therealjohnwall1/ANC_chip/peripherals/readme.md

## list of peripherals
- adc: MCP3008(microchip)
