therealjohnwall1/ANC_chip/chip/doc/theory_of_op.md

# Theory of Operation
Anchor interacts with an external microcontroller for bring up and initialization which includes tunining and defining s_taps
along with filling the MAC to allow for rolling multplications on the first iteration. the ANC logic will take in X[n] (external noise)
from a reference microphone(ADC + analog frontend) which will be abstracted/simulated in this implementation.
Then ANC block will then try to predict tap coefficents W(z) using gradient descent while using hard coded S(z) to also adjust/zero out
the noise.

The full chain of operations is shown below, basically the entire system this logic aims to represent.
Compute Chain
If this is unfamilar, a demo/simulation in [`scripts/ans.py`](../../scripts/ans.py) shows the full algorithm at work.

## system of equations/variables

signals

| var | meaning |
|---|---|
| x(n) | reference signal, the ambient noise picked up by the reference mic, before cancellation |
| y(n) | adaptive filter output, the anti-noise signal generated by W(z), sent to the mixer |
| d(n) | primary noise, the ambient noise as it actually arrives at the error mic (after room/ear acoustics) |
| y_s(n) | anti-noise after the real secondary path, y(n) as it arrives at the error mic |
| e(n) | error signal, residual noise at the error mic, e(n) = d(n) - y_s(n), used only to adapt the weights |
| x_f(n) | filtered reference, x(n) passed through the secondary path estimate S_hat(z), used in the weight update |

system blocks / filters

| var | meaning |
|---|---|
| W(z) | adaptive filter, holds the tap weights that shape x(n) into y(n) |
| w(n) | vector of adaptive filter tap weights at time n (the state W(z) updates each sample) |
| w(n+1) | updated tap weights after the LMS update rule is applied |
| S(z) | actual secondary path, everything physical between the dsp output and the error mic (dac, amp, speaker, air, mic, adc) |
| S_hat(z) | secondary path estimate, a modeled copy of S(z), used to pre-filter the reference so the adaptation direction is correct |

parameters

| var | meaning |
|---|---|
| mu | step size / learning rate, controls how fast the weights adapt, too high causes instability, too low causes slow convergence |

## Design Goals/questions
- these objectives/goals were created in order to spec out/design the chip without going in a loop, below are the questions and answers(Shoutout claude for the questions)

- Q: what is tile budget, and what types
- A: 700 pound per analog/digital tile, analog pin cost 600 pound bro please :(
    Fits around 1000 digital logic gates, flops take more area up then combinationals
    Based on this requirement I will need to limit my sampling rate and how short my impulse response time is, the shorter it is(faster convergence but it linearly relates
    to the number of taps(N) i will use)
    From this requirement first revision will try to use Q1.15 point(16 bit wide) registers to save space

- Q:What is the target attenuation, what frequency bands?
- A: 0-1 khz, around 15-25 db attn. 1-2 khz, 5-10db attn.
    Signal band is 0-2khz, meaning min rate is 4khz. However the fold point on a 4khz is 2khz, basically this means theres no room for a anti-aliasing filter,
    a analog filter needs a transition band to let the signals through, not a absolute number. Basically a filter that could filter right up to 2khz and blocks everything
    is impossible.
    Energy above 2khz will alias onto 0-2khz band. Switching to 16khz(nyquist 8) gives 2-8khz as a transition band for the anti-aliasing to work.

- Q:What is the physical form factor, which gives you reference-to-error mic spacing, which gives you a latency budget in microseconds.
- A: airpods require ~100khz range(lowk should do ngl).

## External Behavior
- The system will sample/take in a digital signal at 16khz, the internal clock runs at 66 Mhz giving the chip 4125 cycles to compute for each sample.
Knowing this, an optimal fold ratio will use the most of these cycles will minimizing the total # of multpliers.
For an estimate solving this inequality for our M folds.

$$
\lceil \frac{3N * \text{cycles per MAC}}{M} \rceil = 4125
$$

- locking in 16khz, W(z) span, S(z) span, and the word width will need to be chosen next.
- W(z) span: how long an impulse response the adaptive FIR can represent
- S(z) span: when sending an impulse to the DAC, speaker(anti-noise) will fire and the sound will propgate to the mic. It will get altered doing so, this is how long from the first
arrival till the response is usable.

- Note: Span is N = time * f_s, the longer span the more taps will be needed in the array
Knowing this we want our W(z) to be larger then S(z), also S(z) will be directly related too $\theta_s$, how long the acoustic path rings for after noise is sent through it.
Since idk the hw enclosure setup for this, I will choose TODO: fill this out ngl idk what to put

- T_s: secondary path ring duration, physical property of enclosure(will get this number from physical setup)
how long the acoustic impulse response of the secondary path S(z) (speaker → error mic) takes to ring down
- T_w: control filter memory horizon, design choice, the length of memory that W(z) spans
T_w = K * t_s

K should be tuned(its prob gonna be 2 cuz of budget)
t_w is the memory horizon time, how far back in the past can it recall samples, this is why t_w > t_s, an echo that arrives t_s after an impulse was caused by a reference t_s ago, to cancel it the
filter should have that sample in reach. Plots in scripts/ans show these relation along with tiles used.

## Duct Setup
- noise canceling will need to happen in a physical system, duct geometry can be configured,
however for the sake of the project I will be using

## Bit width/tap lengths and reasoning
- **Sample rate**:16khz, reasoning above
- **word length: 16 bit, simplest place to start off with, used fixed point operation q1.15 meaing the implementation of the
algorithm will need to change to support this

TODO: speccing out size for this in ../scripts/audio_sim
- **W(z) span**: 32 taps
- **S(z) span**: 32 taps
- reasoning shown below(config I)

## Internal Behavior
- internal FSM hw will be implemented and driven from a microcontroller
- Reasons for init state:
    - need to init and clear the values in the taps, reason why init is needed
    - estimate $\hat{S}$, the secondary path, in the calculation this value is never updated, should also not be hardcoded in incase anything else changes
    - **decision choice**: can you store a converged secondary path estimate once in non volatile memory instead of having to calculate everytime on power up?
- State machine diagram:
power -> reset -> init(maybe merge the two) -> sample_start -> power off(idk if needed)
TODO: turn into mermaid diagram

## Viable span/tap options (measured)

Swept the (N_W, M) plane over 4 duct configs, code in [`scripts/audio_sim/sweep.py`](../../scripts/audio_sim/sweep.py).
All rows 16khz, 16 bit, 1 multiplier. tau = taps / f_s, M picked per row for the best margin over target.
Tiles from [`scripts/budget_model.py`](../../scripts/budget_model.py), reported but not a constraint, first target is fpga.

| # | duct | tau_W / N_W | tau_S / M | 0-1 khz | 1-2 khz | tiles |
|---|---|---|---|---|---|---|
| A | 1.2 m, g=0.7 (as built) | 16.0 ms / 256 | 16.0 ms / 256 | 20.1 | 12.7 | 53 |
| B | 1.2 m, g=0.7 (as built) | 8.0 ms / 128 | 8.0 ms / 128 | 16.1 | 9.9 | 27 |
| C | 1.2 m, g=0.7 (as built) | 4.0 ms / 64 | 16.0 ms / 256 | 11.0 | 5.3 | 24 |
| D | 1.2 m, g=0.3 (damped) | 16.0 ms / 256 | 16.0 ms / 256 | 35.0 | 28.3 | 53 |
| E | 1.2 m, g=0.3 (damped) | 8.0 ms / 128 | 16.0 ms / 256 | 26.8 | 21.4 | 34 |
| F | 0.3 m, g=0.5 (short) | 8.0 ms / 128 | 4.0 ms / 64 | 31.7 | 20.1 | 24 |
| G | 0.3 m, g=0.5 (short) | 4.0 ms / 64 | 4.0 ms / 64 | 26.1 | 15.2 | 14 |
| H | 0.3 m, g=0.1 (short+damped) | 8.0 ms / 128 | 1.0 ms / 16 | 44.8* | 33.5* | 22 |
| I | 0.3 m, g=0.1 (short+damped) | 2.0 ms / 32 | 2.0 ms / 32 | 43.6* | 33.1* | 8 |

- Target is 15-25db over 0-1khz, 5-10db over 1-2khz. Every row clears it, B and C barely. Row A is the best the duct on the bench does.
- g is the reflection coeff applied per bounce, same at both ends. Lumped stand in for termination absorption, not measured off hw yet. Highest leverage knob by far, A -> D is g 0.7 -> 0.3 for +15db on identical silicon. One round trip = two bounces, so decay is 40*log10(g) db per 2L/c.
- \* H and I are sitting on the sim's -40db error mic noise floor(broadband ~38db). Band numbers read higher cuz a band limited measurement can dig under a broadband floor, so read them as ">= 38db", not a prediction.
- **I configuration will be targeted**, however this is done in fp64 and other factors so its not finalized

### Assumptions
- sim choices not measurements, the table is only as good as these
- 2s adaptation budget. with an exact S_hat and no sensor noise fxlms just keeps improving(512 taps hit 91db at 50s, still climbing) so theres no steady state to report. this is why every curve peaks then falls, past the peak it cant converge in time
- -40db error mic noise floor, caps attenuation ~40db no matter the tap count
- nlms, lr searched over (0.3, 0.1, 0.03), best stable one kept
- real S(z) kept full length, only S_hat truncated to M
- use float64 in calculations
- duct width isnt in the model at all. 1d image source assumes plane waves, only valid below f < c/2d, so width < ~86mm to cover 0-2khz or < ~21mm to cover to nyquist. nothing checks this, if the real duct is wider every tap count above is optimistic
- causal margin scales with L, 37 taps at 1.2m and 9.3 taps(~580us) at 0.3m. adc/dac + anti aliasing delay eats straight into it, once its negative no FIR W(z) cancels anything

## Measured ranges (float64, for fixed point sizing)

From [`scripts/range_check.py`](../../scripts/range_check.py). Accumulator columns are max partial sum, normalized to |x| <= 1.
Max abs values of weights and secondary path are already normalized, so we only need to worry about precision.

| row | max abs w[k] | max abs s_hat[k] | acc peak W.x | acc peak S.x | sum abs w[k] |
|---|---|---|---|---|---|
| G (N_W=64, M=64) | 0.795 | 0.824 | 1.17 | 1.33 | 4.23 |
| I (N_W=32, M=32) | 0.719 | 0.824 | 1.07 | 1.02 | 3.24 |

## coefficents width
- fp64 imppl in [`scripts/range_check.py](../../scripts/range_check.py), showed the following
- max abs w[k]: 16 bit
- max abs s[k]: 16 bit
- 16 bit works, filtering is around 9 and stall is around 12, giving 4 bits of headroom for precision, however
this should be revised and tune again if needed
- floor for now

## accumulator width
- acc width: 64
- prob will never fill or even get close, this is to play it safe, super low cost
- floor for now

## optimizer algorithm
- support for both LMS and NLMS will be implmented, however will start off with NLMS since its easier/less resources
to implement
