therealjohnwall1/ANC_chip/chip/doc/calcuations.md

# calcuations for hyperparameters
this will be the sound setup(its primitive because shorter distances would require a higher sample time)
```
[ref mic] ---------- duct ---------- [speaker] -- [error mic]
    0 m                                 0.8 m         1.0 m

C = 343 m/s(speed of sound room temp)
```
Need to calculate $\theta_s$ for a 16khz sample rate, for this see theory_of_op.md for context
