therealjohnwall1/ANC_chip/chip/doc/png/cts_default_core_clock.png

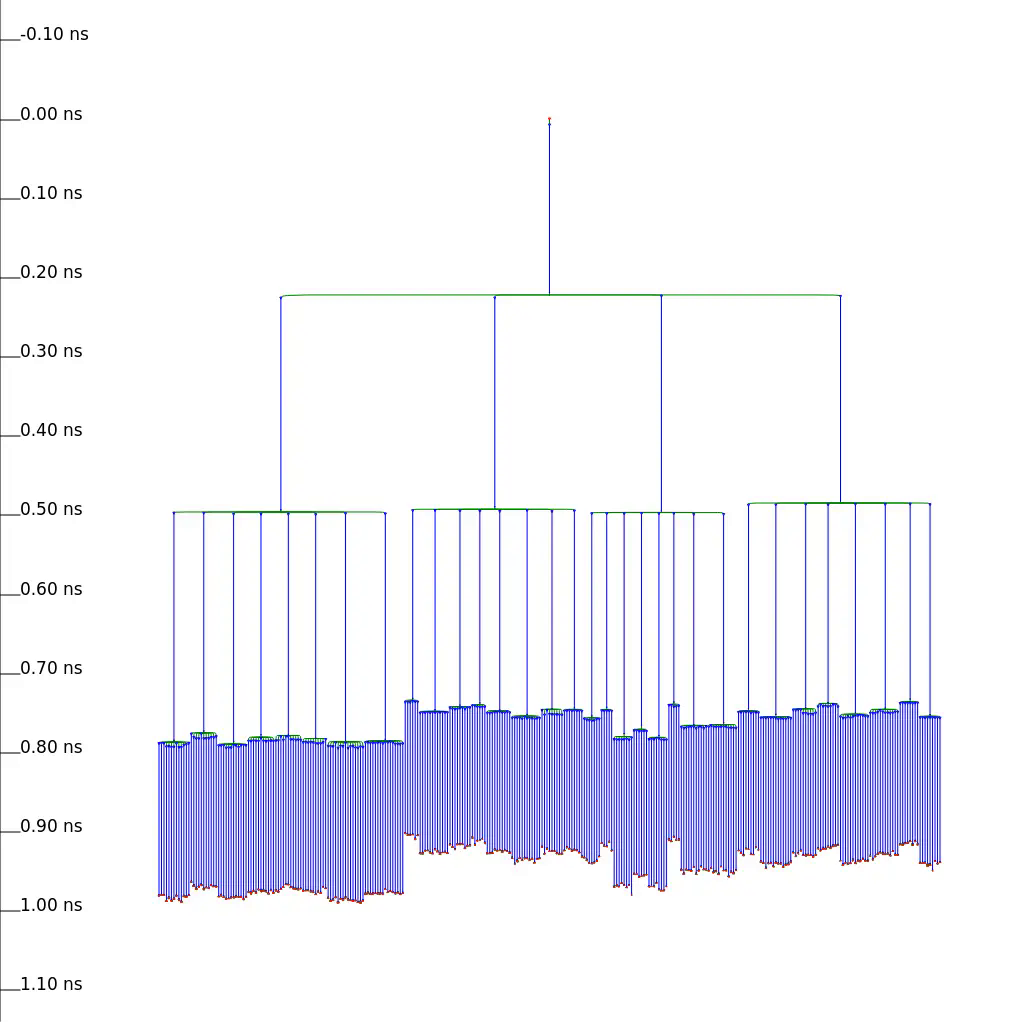
chip/doc/png/cts_default_core_clock.png
