therealjohnwall1/ANC_chip/chip/doc/png/cts_default_core_clock_layout.png

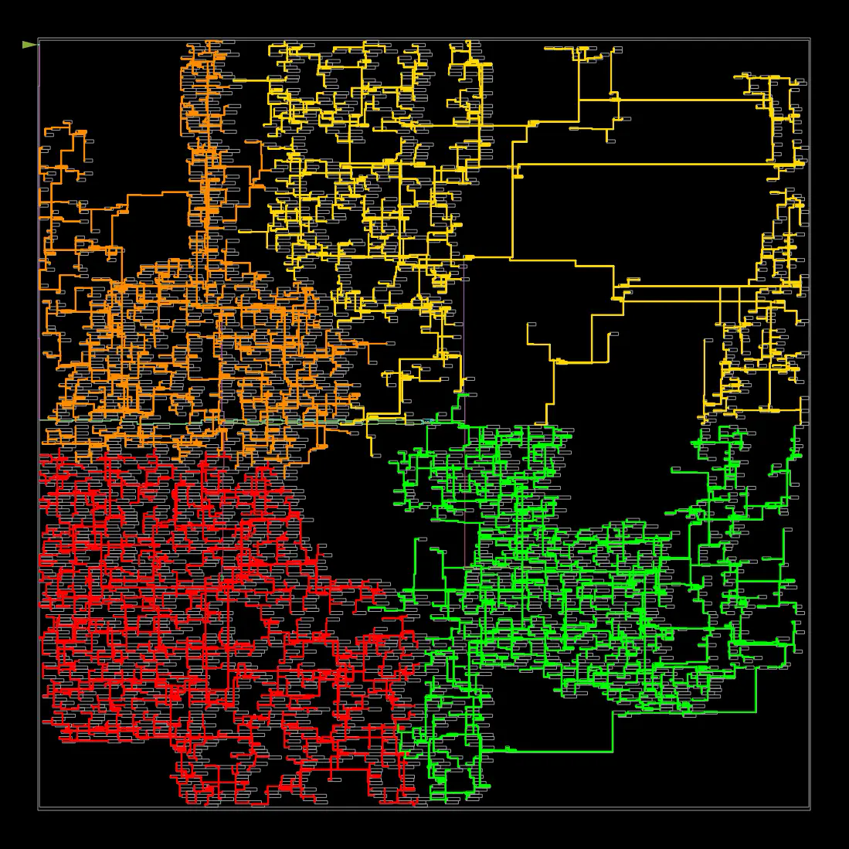
chip/doc/png/cts_default_core_clock_layout.png
