therealjohnwall1/ANC_chip/chip/doc/png/final_congestion.png

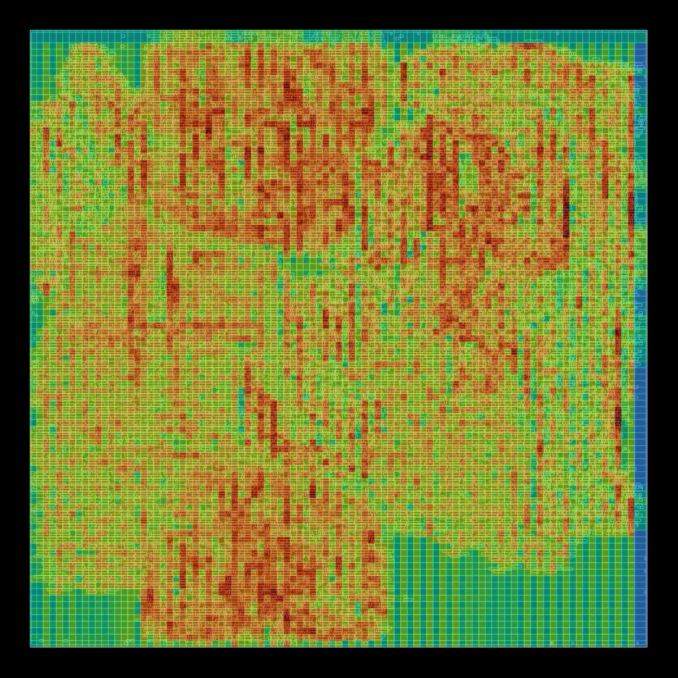
chip/doc/png/final_congestion.png
