therealjohnwall1/ANC_chip/chip/doc/png/final_ir_drop.png

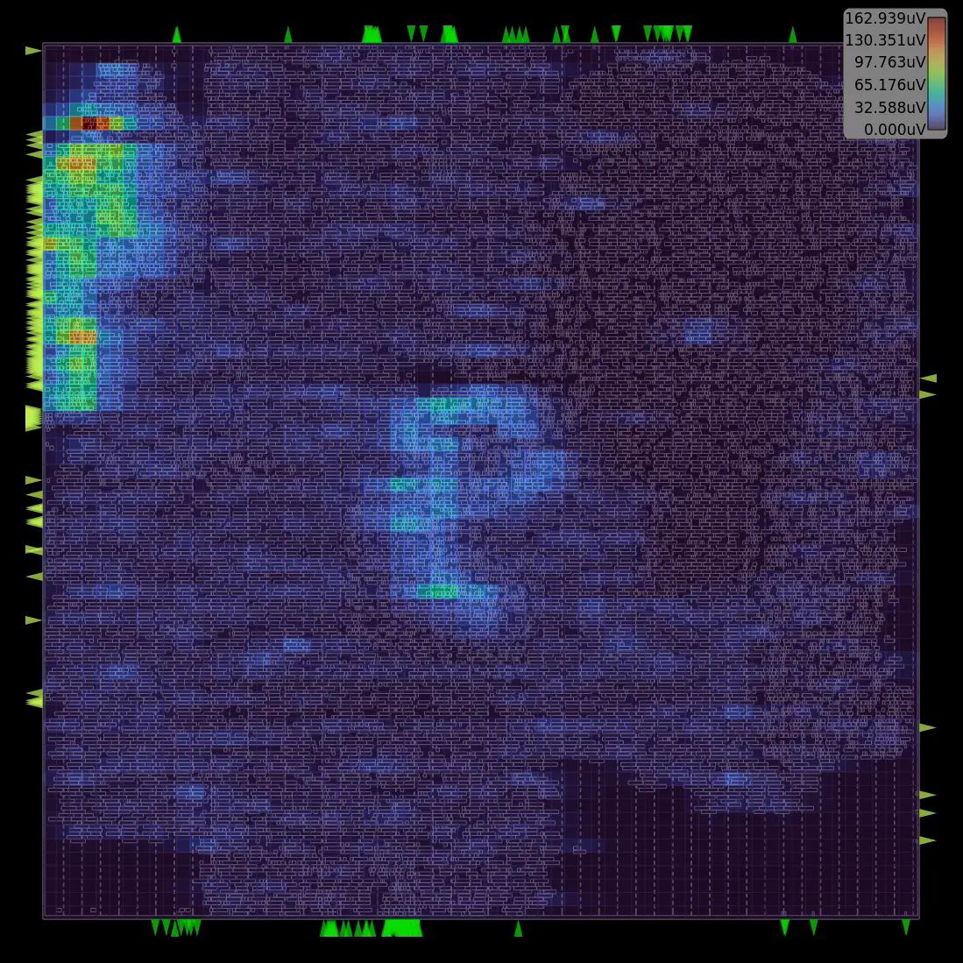
chip/doc/png/final_ir_drop.png
