therealjohnwall1/ANC_chip/chip/doc/png/final_placement.png

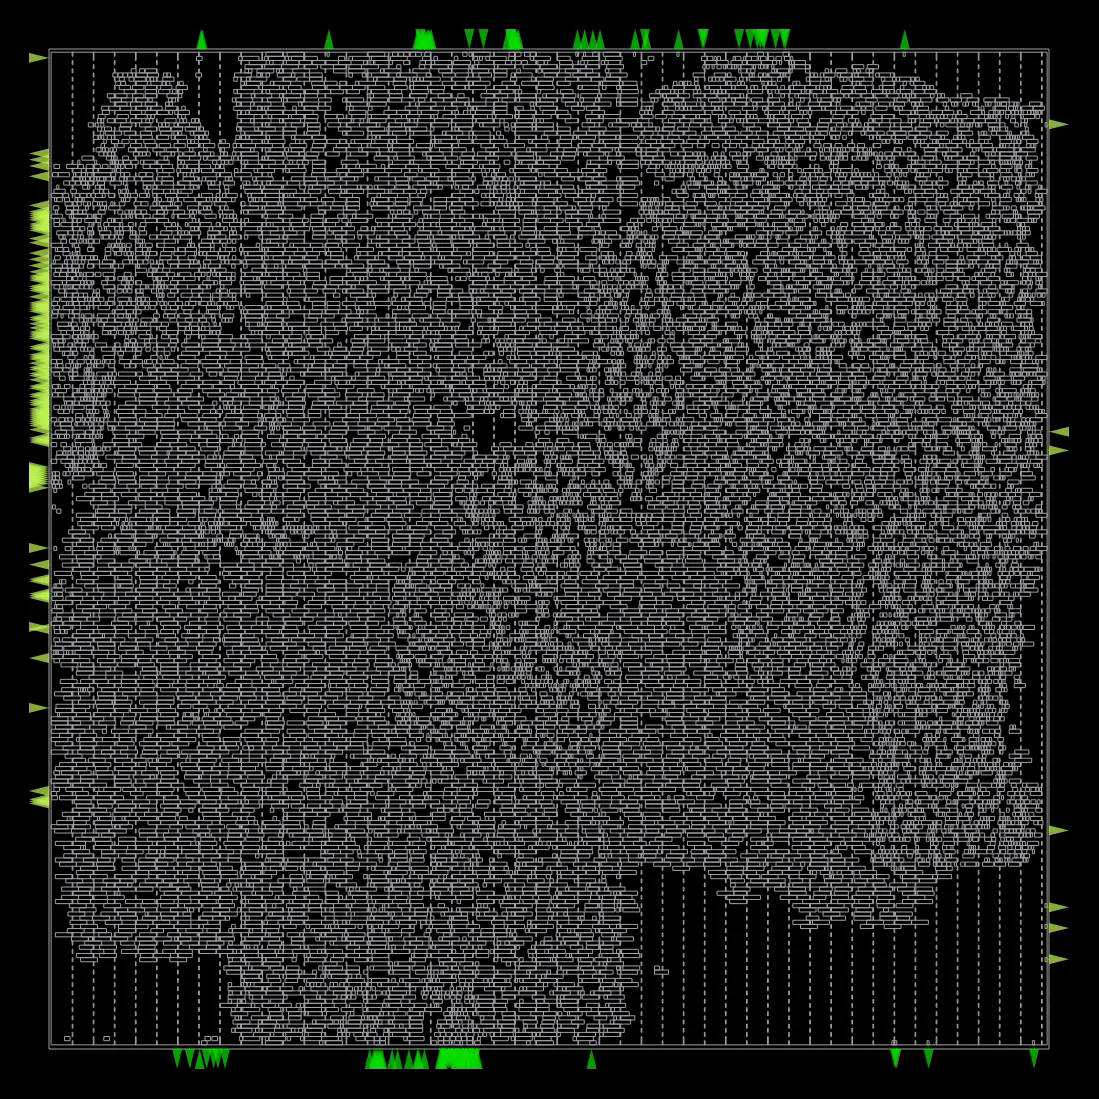
chip/doc/png/final_placement.png
