therealjohnwall1/ANC_chip/chip/doc/png/final_resizer.png

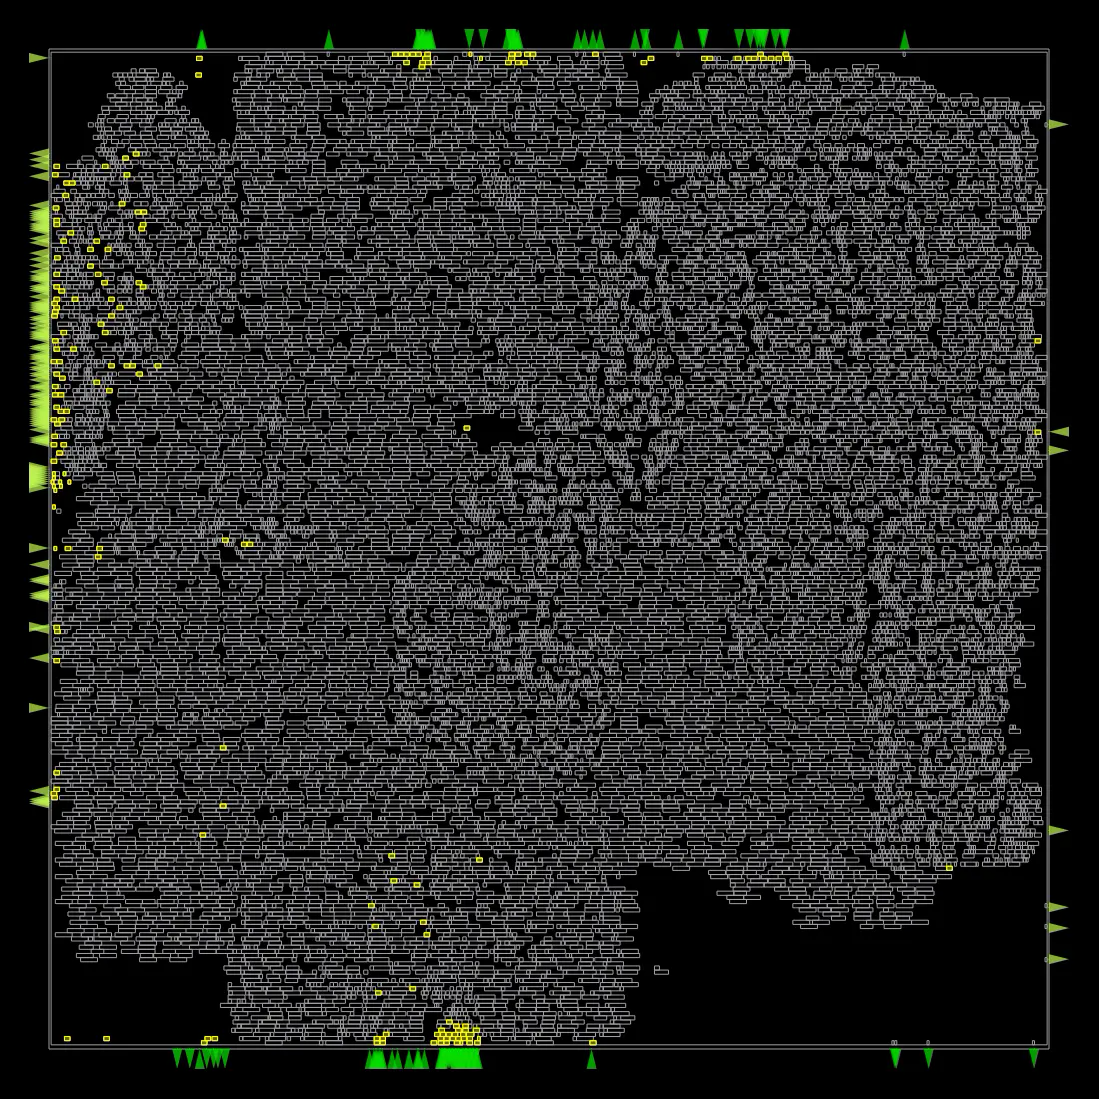
chip/doc/png/final_resizer.png
