therealjohnwall1/ANC_chip/chip/doc/png/final_worst_path.png

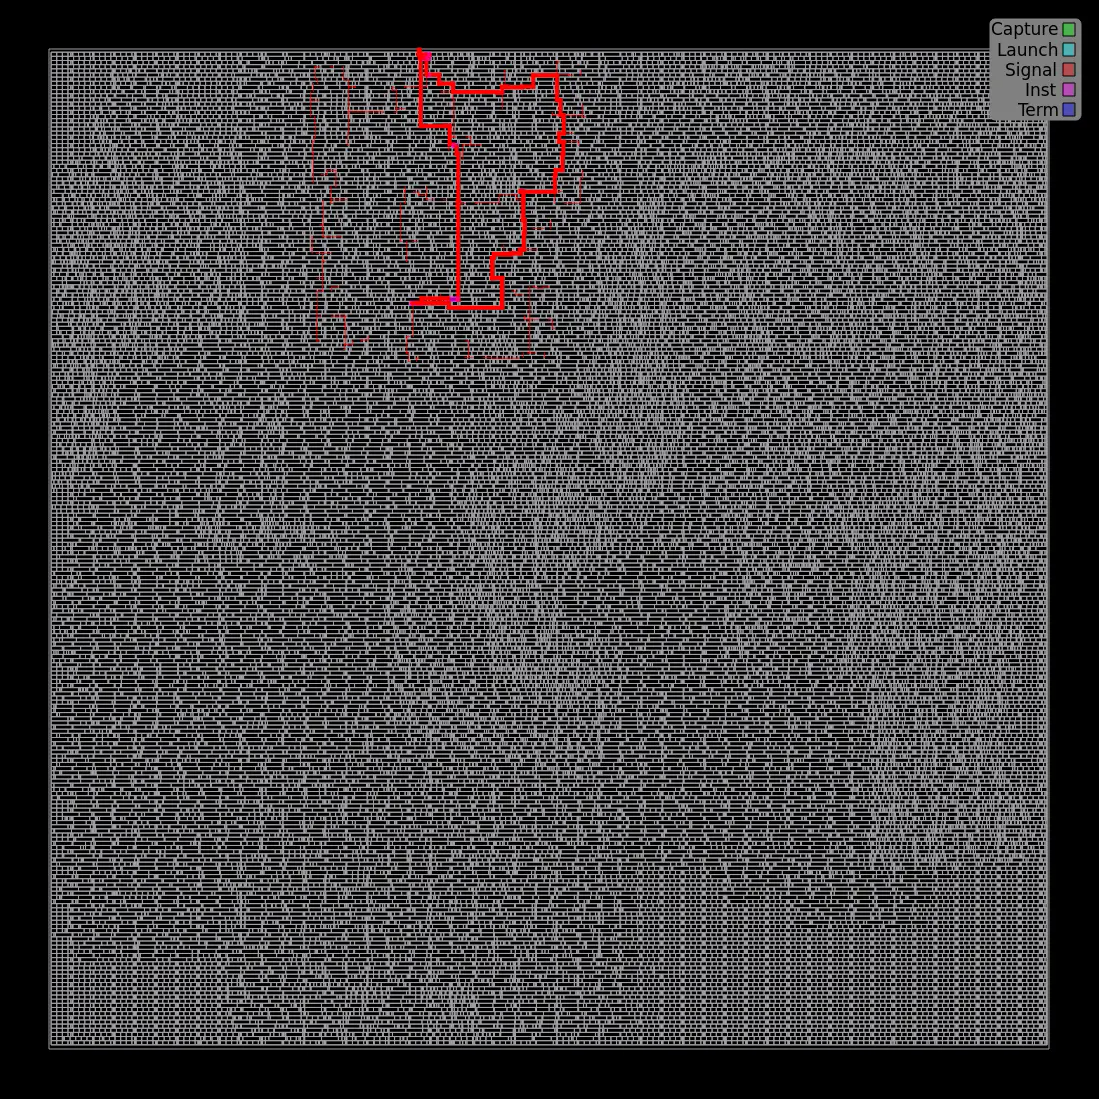
chip/doc/png/final_worst_path.png
