therealjohnwall1/ANC_chip/scripts/out/budget_feasible_region.png

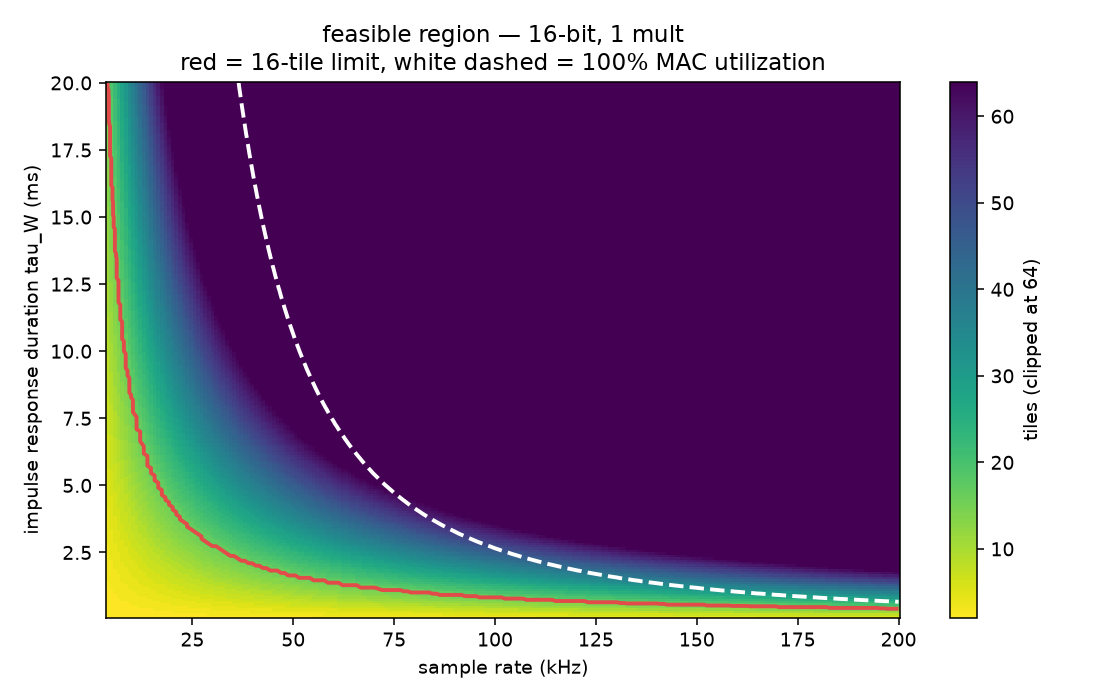
scripts/out/budget_feasible_region.png
