therealjohnwall1/ANC_chip/scripts/out/budget_taps_vs_width.png

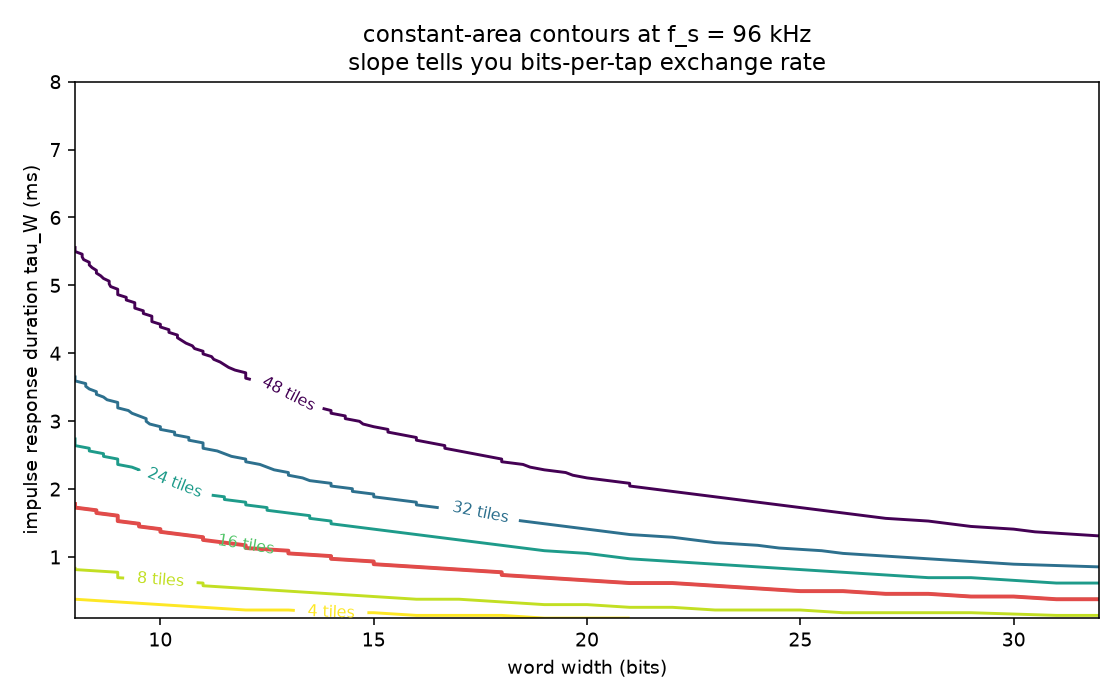
scripts/out/budget_taps_vs_width.png
