therealjohnwall1/ANC_chip/scripts/out/budget_vs_fs.png

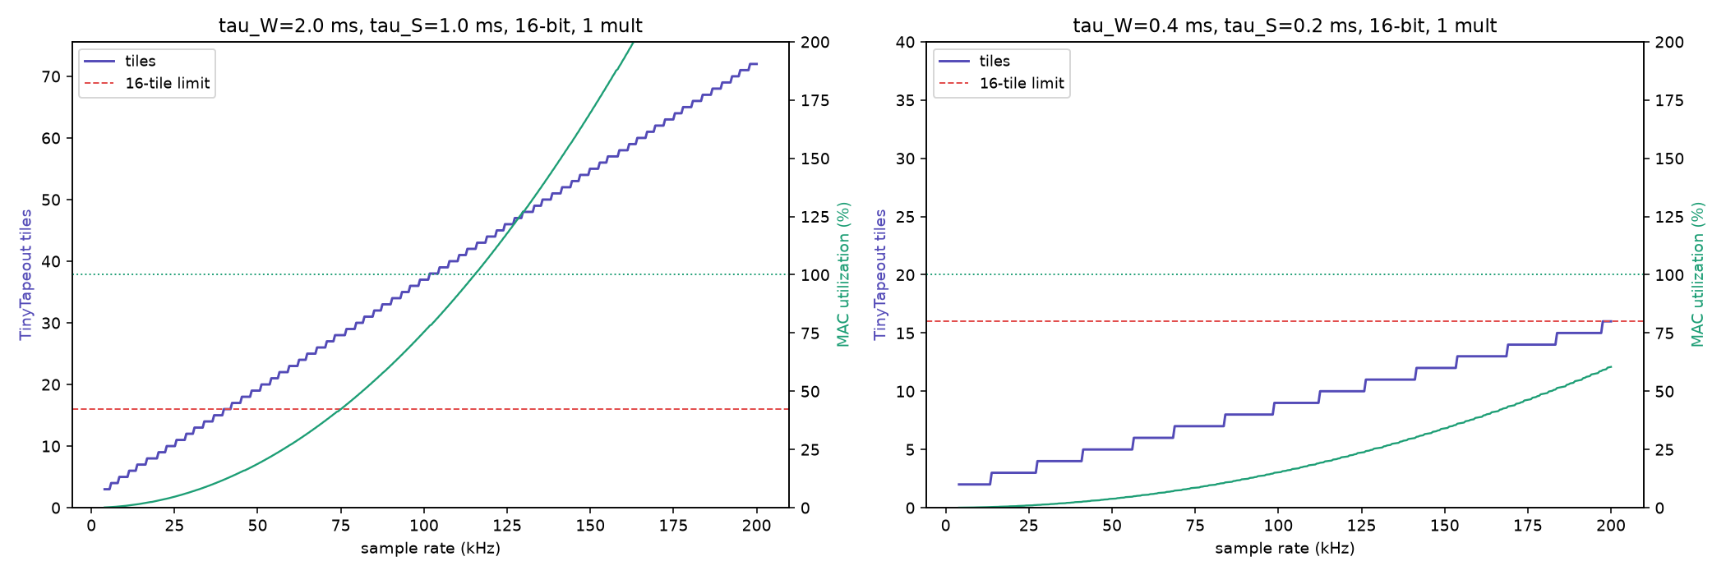
scripts/out/budget_vs_fs.png
