therealjohnwall1/ANC_chip/scripts/out/spans_geometry.png

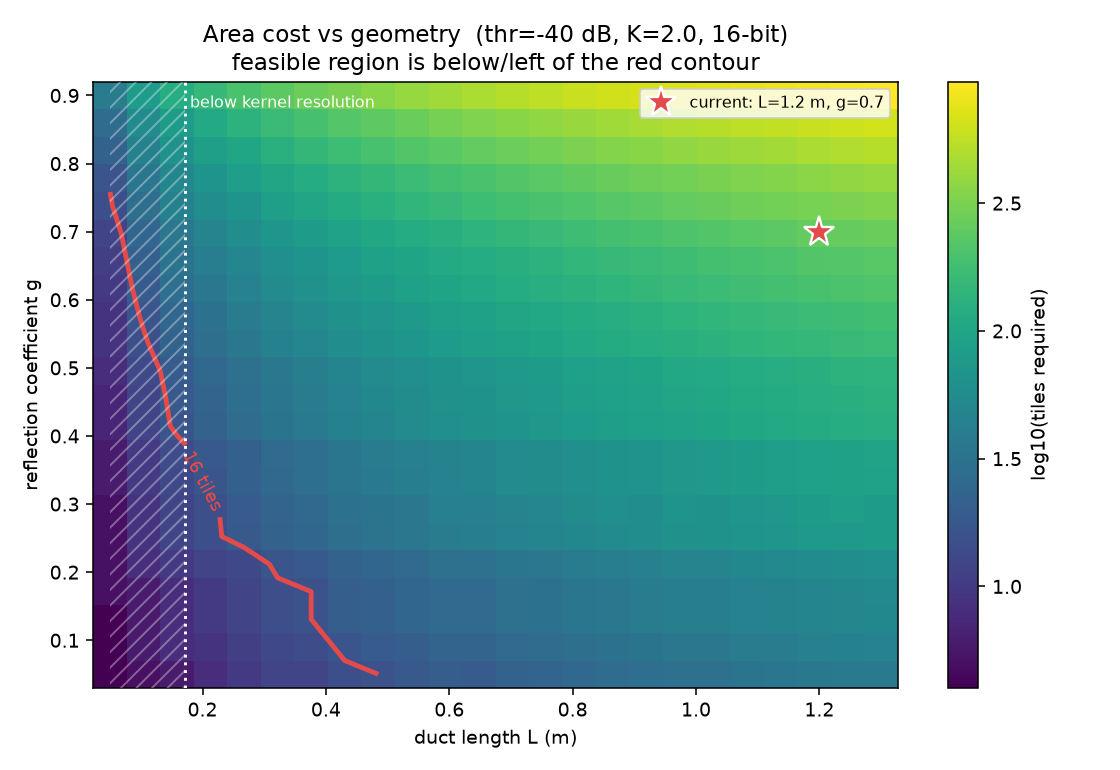
scripts/out/spans_geometry.png
