therealjohnwall1/ANC_chip/scripts/out/sweep_attenuation.png

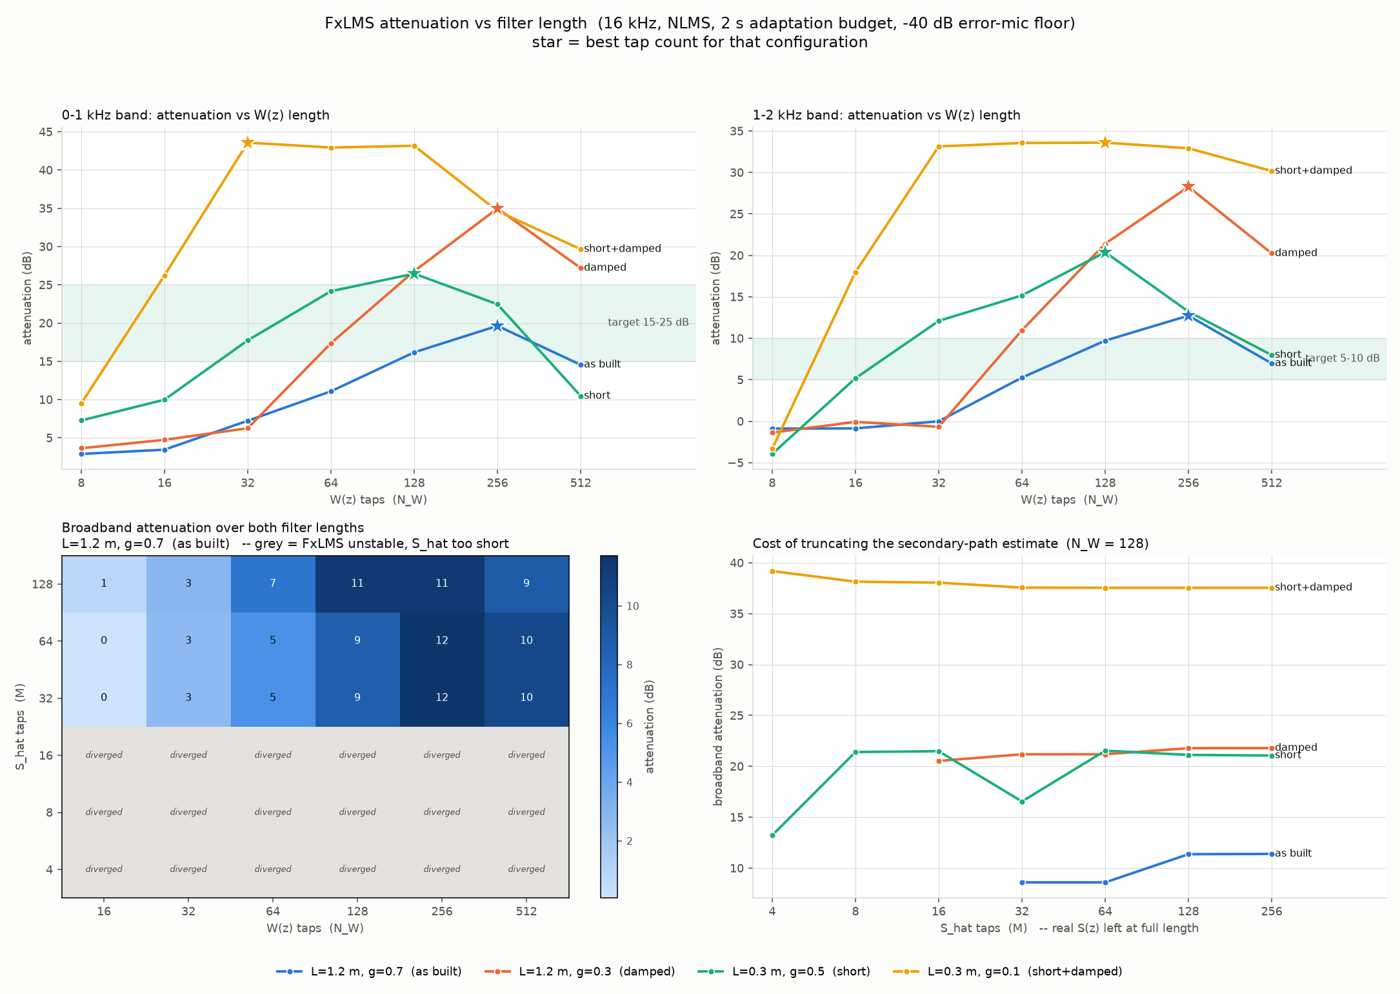
scripts/out/sweep_attenuation.png
