therealjohnwall1/ANC_chip/chip/dv/sample_in_tb.sv

module sample_in_tb;

  import globals::*;
  import dv_globals::*;

  localparam int CYC_TB = 4;

  localparam time CLK_PERIOD = 20ns;

  logic clk;
  logic rst_n;
  logic data_rdy;
  logic data_valid;
  logic [INPUT_WIDTH-1:0] data_in;
  sample_t x_n;
  logic x_n_new;
  logic [$clog2(globals::HIST_DEPTH)-1:0] head_idx;
  logic [$clog2(globals::HIST_DEPTH)-1:0] exp_head = '0;

  localparam int TAP_CNT_W = $clog2(globals::TAP_LEN);
  logic [$clog2(globals::HIST_DEPTH)-1:0] x_tap_sel;
  sample_t x_tap_out;
  sample_t exp_win[globals::HIST_DEPTH];
  logic [INPUT_WIDTH-1:0] drv_c;
  logic [$clog2(globals::HIST_DEPTH)-1:0] scan_addr;

  sample_in dut (
      .clk       (clk),
      .rst_n     (rst_n),
      .data_rdy  (data_rdy),
      .data_valid(data_valid),
      .data_in   (data_in),
      .x_n       (x_n),
      .x_n_new   (x_n_new),
      .head_idx  (head_idx),
      .x_tap_sel (x_tap_sel),
      .x_tap_out (x_tap_out)
  );

  initial begin
    clk = 1'b0;
    forever #(CLK_PERIOD / 2) clk = ~clk;
  end

  initial begin
    $dumpfile({DV_OUT_DIR, "sample_in_tb.vcd"});
    $dumpvars(0, sample_in_tb);
  end

  task automatic drive_sample(input logic [INPUT_WIDTH-1:0] d, input logic rdy, input logic val);
    @(negedge clk);
    data_in    = d;
    data_rdy   = rdy;
    data_valid = val;
    @(posedge clk);
    @(negedge clk);
    data_rdy   = 1'b0;
    data_valid = 1'b0;
  endtask

  function automatic sample_t expected(input logic [INPUT_WIDTH-1:0] d);
    return sample_t'({~d[INPUT_WIDTH-1], d[INPUT_WIDTH-2:0], {(WORD_LEN - INPUT_WIDTH) {1'b0}}});
  endfunction

  initial begin
    rst_n <= 1'b0;
    data_rdy <= 1'b0;
    data_valid <= 1'b0;
    data_in <= '0;
    repeat (4) @(posedge clk);
    rst_n <= 1'b1;

    repeat (CYC_TB) @(posedge clk);

    $display("T=%0t: reset released", $time);
    if (head_idx !== '0) $fatal(1, "reset did not clear head_idx");

    @(negedge clk);
    data_in <= 12'h123;
    data_rdy <= 1'b0;
    data_valid <= 1'b1;
    @(posedge clk);
    @(negedge clk);
    data_rdy   <= 1'b0;
    data_valid <= 1'b0;
    assert (x_n_new === 1'b0)
    else $fatal(1, "x_n_new fired with data_rdy low");
    if (x_n !== '0) $display("note: x_n changed on non-valid handshake");
    if (head_idx !== '0) $fatal(1, "head_idx advanced on non-valid handshake");

    repeat (CYC_TB) @(posedge clk);

    drive_sample(12'h7FF, 1'b1, 1'b1);
    if (x_n !== expected(12'h7FF)) $fatal(1, "x_n wrong for 0x7FF");
    if (x_n_new !== 1'b1) $fatal(1, "x_n_new not strobed");
    exp_head++;
    if (head_idx !== exp_head) $fatal(1, "head_idx != %0d", exp_head);
    $display("T=%0t: 0x7FF -> x_n=%h x_n_new=%0d", $time, x_n, x_n_new);

    repeat (CYC_TB) @(posedge clk);
    if (x_n_new !== 1'b0) $fatal(1, "x_n_new not one-cycle");

    drive_sample(12'h800, 1'b1, 1'b1);
    if (x_n !== expected(12'h800)) $fatal(1, "x_n wrong for 0x800");
    exp_head++;
    if (head_idx !== exp_head) $fatal(1, "head_idx != %0d", exp_head);
    $display("T=%0t: 0x800 -> x_n=%h", $time, x_n);

    repeat (CYC_TB) @(posedge clk);

    drive_sample(12'h000, 1'b1, 1'b1);
    if (x_n !== expected(12'h000)) $fatal(1, "x_n wrong for 0x000");
    exp_head++;
    if (head_idx !== exp_head) $fatal(1, "head_idx != %0d", exp_head);
    $display("T=%0t: 0x000 -> x_n=%h", $time, x_n);

    repeat (CYC_TB) @(posedge clk);

    drive_sample(12'hFFF, 1'b1, 1'b1);
    if (x_n !== expected(12'hFFF)) $fatal(1, "x_n wrong for 0xFFF");
    exp_head++;
    if (head_idx !== exp_head) $fatal(1, "head_idx != %0d", exp_head);
    $display("T=%0t: 0xFFF -> x_n=%h", $time, x_n);

    repeat (CYC_TB) @(posedge clk);

    x_tap_sel <= 'd0;
    @(negedge clk);
    if (x_tap_out !== expected(12'h7FF)) $fatal(1, "tap 0 wrong");
    $display("T=%0t: tap[0]=%h", $time, x_tap_out);
    x_tap_sel <= 'd1;
    @(negedge clk);
    if (x_tap_out !== expected(12'h800)) $fatal(1, "tap 1 wrong");
    $display("T=%0t: tap[1]=%h", $time, x_tap_out);
    x_tap_sel <= 'd2;
    @(negedge clk);
    if (x_tap_out !== expected(12'h000)) $fatal(1, "tap 2 wrong");
    $display("T=%0t: tap[2]=%h", $time, x_tap_out);
    x_tap_sel <= 'd3;
    @(negedge clk);
    if (x_tap_out !== expected(12'hFFF)) $fatal(1, "tap 3 wrong");
    $display("T=%0t: tap[3]=%h", $time, x_tap_out);

    for (int n = 0; n < globals::TAP_LEN; n++) begin
      drv_c = 12'h200 + INPUT_WIDTH'(n);
      exp_win[exp_head] = expected(drv_c);
      drive_sample(drv_c, 1'b1, 1'b1);
      exp_head++;
      if (head_idx !== exp_head) $fatal(1, "head_idx != %0d", exp_head);
    end

    for (int k = 0; k < globals::TAP_LEN; k++) begin
      scan_addr = head_idx - 1'b1 - TAP_CNT_W'(k);
      x_tap_sel <= scan_addr;
      @(negedge clk);
      if (x_tap_out !== exp_win[scan_addr]) $fatal(1, "scan mismatch k=%0d", k);
    end
    $display("T=%0t: full-window scan ok (newest=head_idx-1)", $time);

    repeat (CYC_TB) @(posedge clk);

    rst_n <= 1'b0;
    repeat (2) @(posedge clk);
    if (x_n !== '0) $fatal(1, "reset did not clear x_n");
    if (x_n_new !== 1'b0) $fatal(1, "reset did not clear x_n_new");
    if (head_idx !== '0) $fatal(1, "reset did not clear head_idx");
    $display("T=%0t: reset cleared x_n/x_n_new", $time);
    rst_n <= 1'b1;

    $display("T=%0t: TB done.", $time);
    $finish;
  end

  initial begin
    #10ms $fatal(1, "timeout");
  end

endmodule
