therealjohnwall1/ANC_chip/(commit log)

2026-08-04 compute chain diagram
2026-08-18 audio duct simulation of setup, physical setup/hyperparameters established
2026-08-19 range check for filter precision
2026-08-26 add circular buffer for sample_in + TB
2026-08-26 main impl of sample in
2026-08-26 anti-noise first path impl and test
    [anchor_top.sv, anti_noise_est.sv, anti_noise_tb.sv, sample_in.sv, sample_in_tb.sv]
2026-08-29 placeholder error block, gt stashed
    [anti_noise_est.sv, error_block.sv, globals.sv]
2026-08-29 clean error block, need div
    [error_block.sv]
2026-09-04 fix 1 off err anti noise
    [anti_noise_est.sv, anti_noise_tb.sv, globals.sv, sample_in.sv, sample_in_tb.sv]
2026-09-09 agent genearated connectors for serial to anchor
